Sedokan54/Negatif-Iyonizer-Devre-Tasarimi/1-1PCBLayout.png

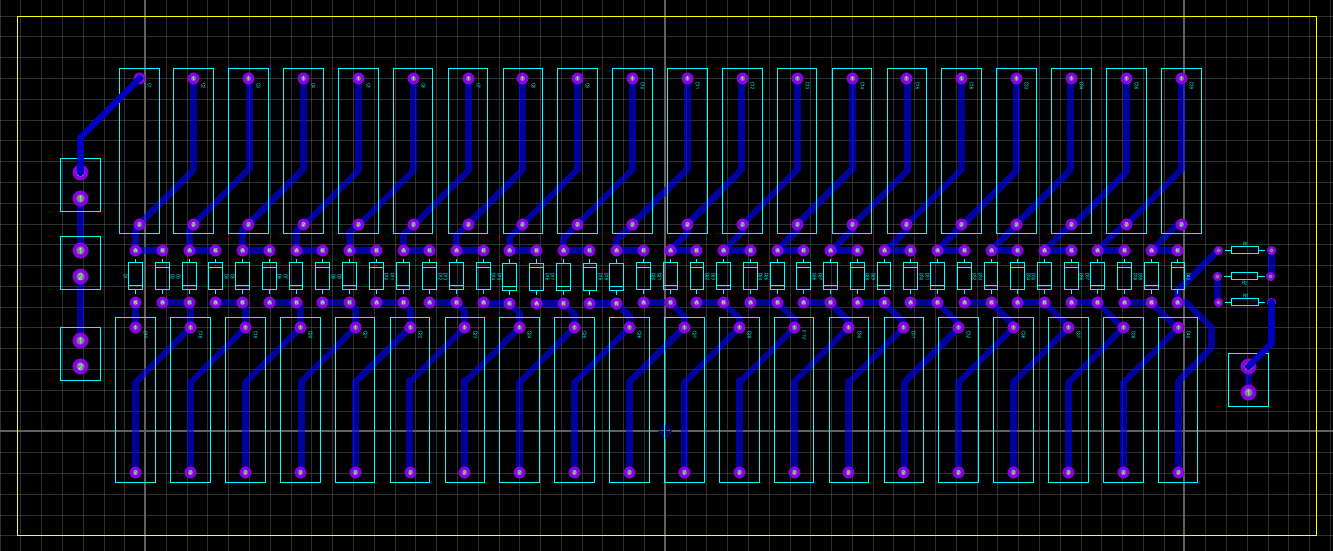
1-1PCBLayout.png
