Sedokan54/Negatif-Iyonizer-Devre-Tasarimi/Vout.png

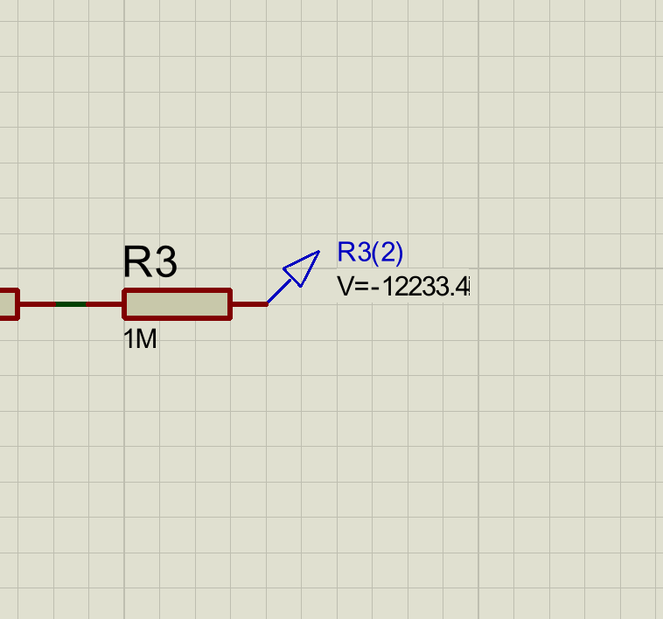
Vout.png
