Sedokan54/Negatif-Iyonizer-Devre-Tasarimi/Şematik.png

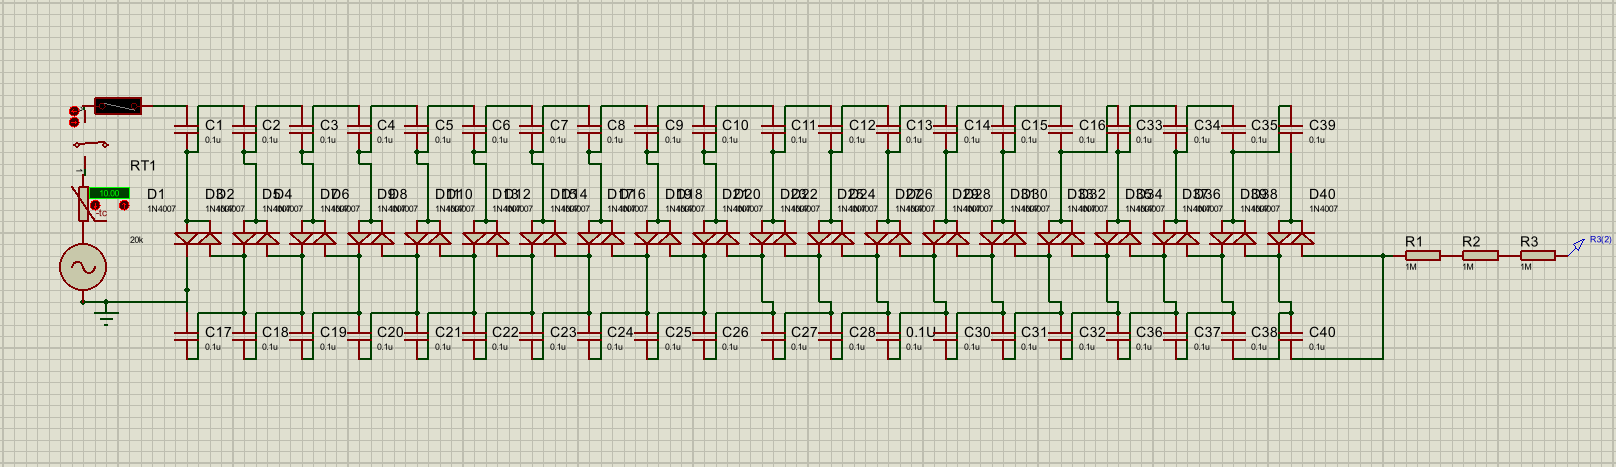
Şematik.png
