Sedokan54/Negatif-Iyonizer-Devre-Tasarimi/Mirrored1-1PCBLayout.pdf

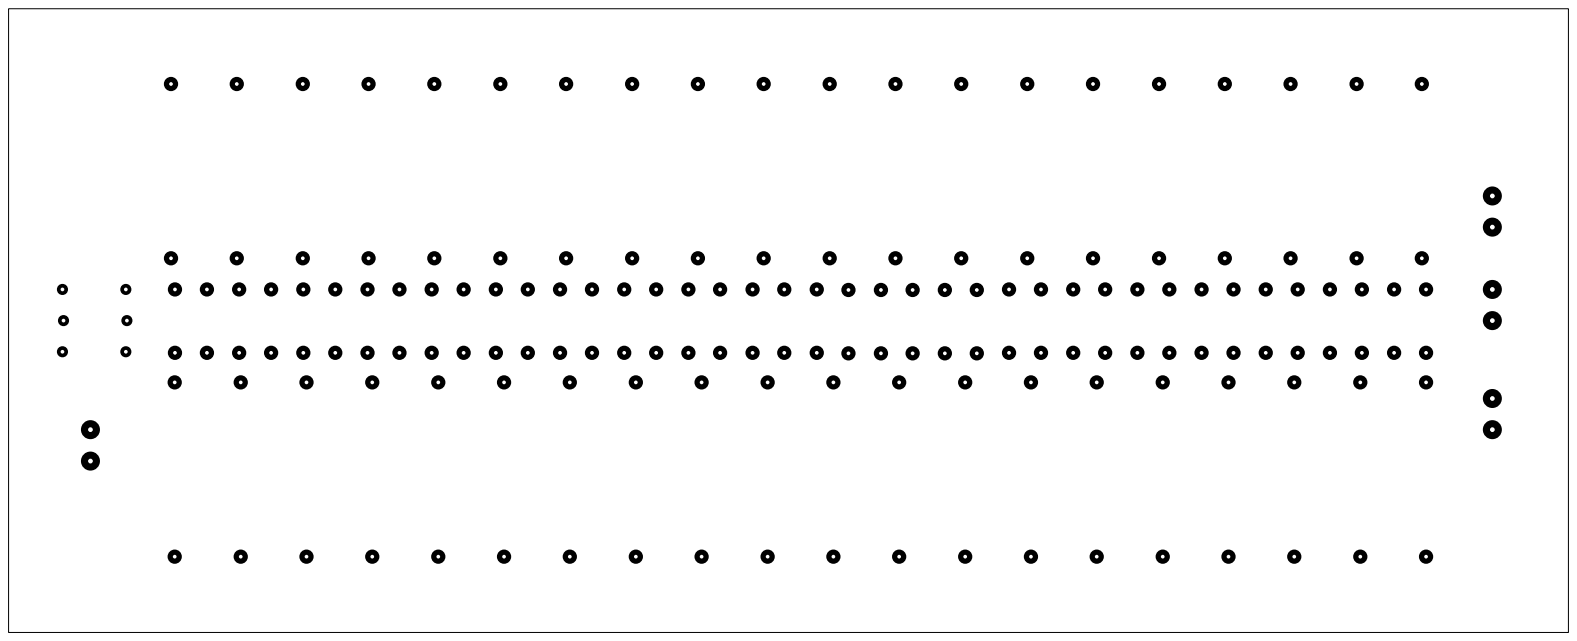
[picture p4: page 1]

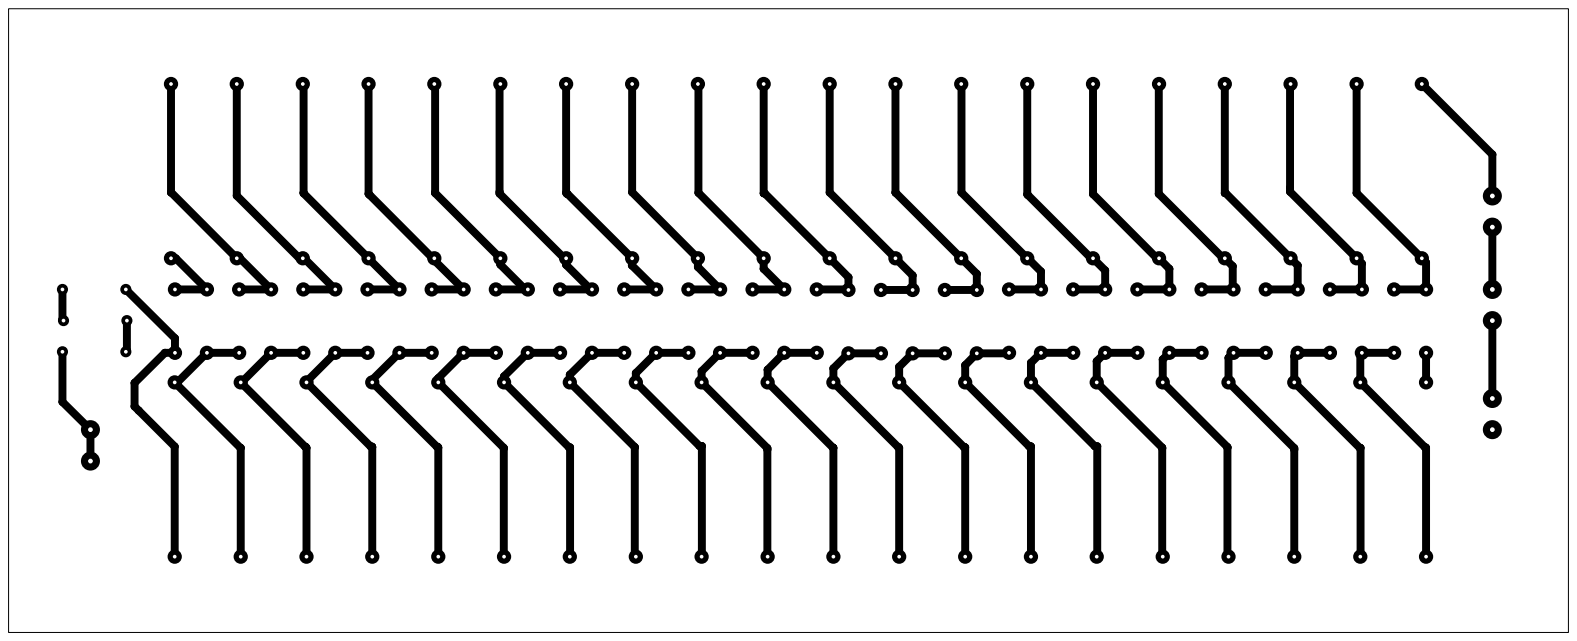
[picture p5: page 2]
