Sedokan54/Negatif-Iyonizer-Devre-Tasarimi/ProjeDosyalari/onlyBottomMirrored.pdf

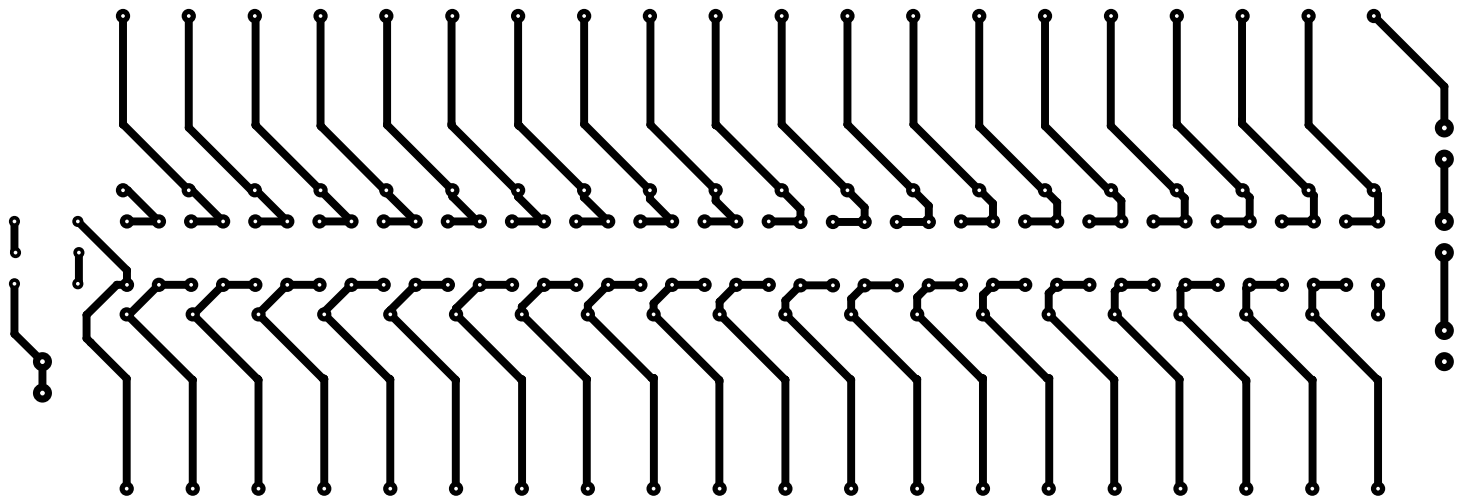
[picture p6: page 1]
