Sedokan54/Negatif-Iyonizer-Devre-Tasarimi/(commit log)

2025-10-13 Update PCB layout and Vout images for improved design accuracy
2025-10-15 Add initial design for bestsave.rte with multiple signal layers and defined padstacks
    - Created a new file bestsave.rte with a comprehensive routing structure.
    - Defined 14 signal layers (I1 to I14) along with TOP and BOT layers.
    - Implemented padstacks for signal and power connections.
    - Established multiple nets with detailed wire paths and connections.
    - Included protection types for NC and VOID nets.
